wemaxon/IAscher/3d/stl/visor_v1_0_Visor_inner.stl

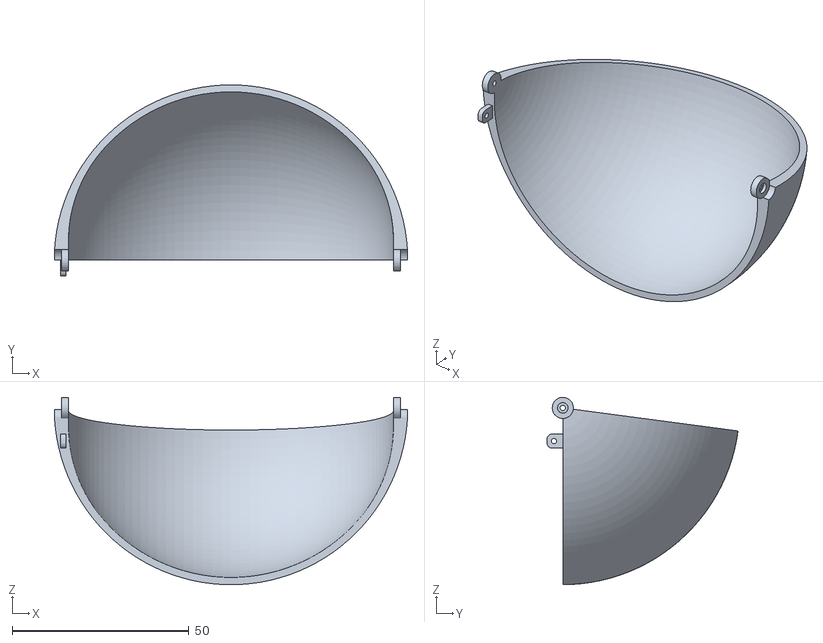
[picture p4: CAD file, 2026-07-22]
3d/stl/visor_v1_0_Visor_inner.stl
99.8 x 54.1 x 53.0
