wemaxon/IAscher/3d/stl/visor_v1_0_cup_insert.stl

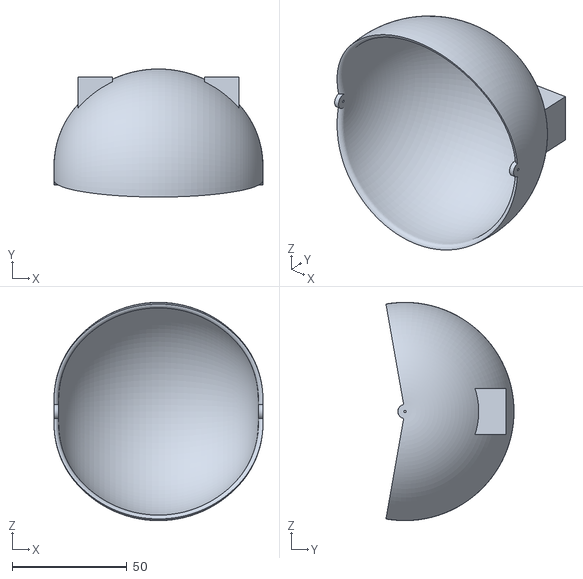
[picture p5: CAD file, 2026-07-22]
3d/stl/visor_v1_0_cup_insert.stl
91.0 x 55.7 x 95.0
