wemaxon/IAscher/3d/stl/visor_v1_0_shell.stl

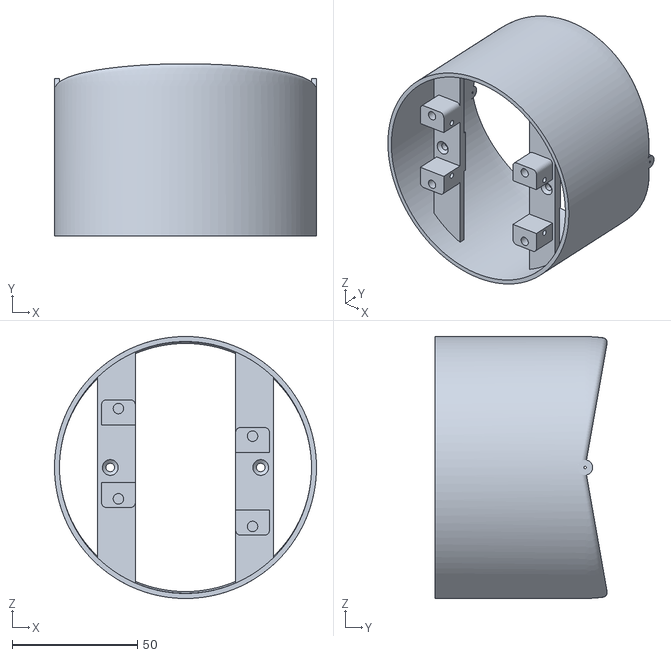
[picture p6: CAD file, 2026-07-22]
3d/stl/visor_v1_0_shell.stl
104.5 x 68.8 x 104.5
