wemaxon/IAscher/3d/stl/visor_v1_0_bottom.stl

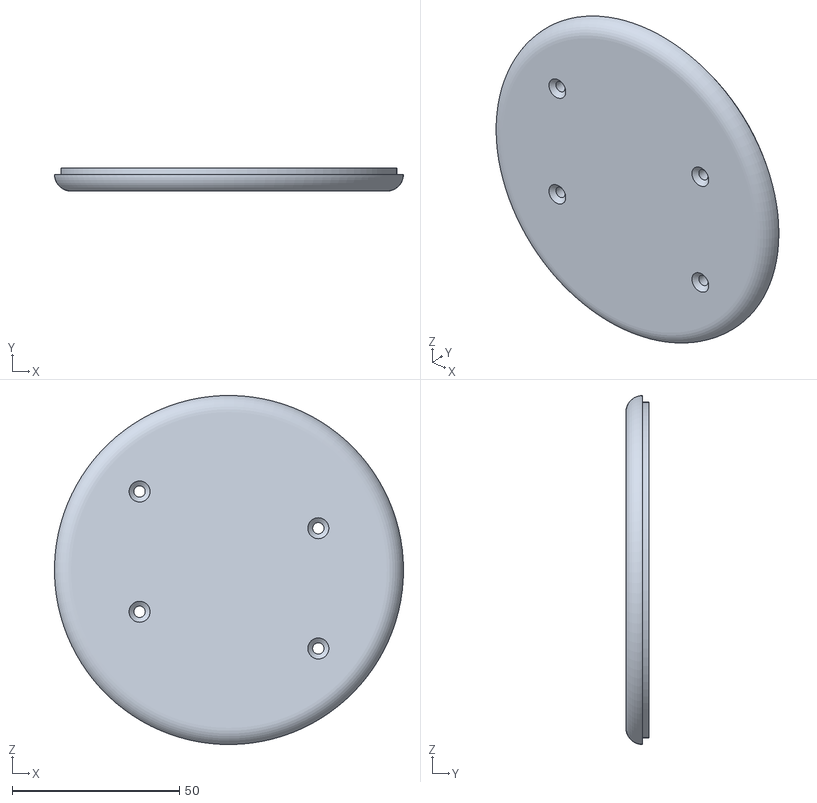
[picture p7: CAD file, 2026-07-22]
3d/stl/visor_v1_0_bottom.stl
104.5 x 7.00 x 104.5
