wemaxon/IAscher/(list of files, cad)

Other CAD files:
3d/stl/visor_v1_0_Visor_outer.stl
