wemaxon/IAscher/(commit log)

2024-01-01 servos working
2024-01-01 add i2c scanner
2024-01-01 add BMI160 Sensor API as submodule
2024-01-01 dumo imu data
2026-07-22 add 3d files
    [IAscher_visor_v1_0_Visor_inner.stl, IAscher_visor_v1_0_Visor_outer.stl, IAscher_visor_v1_0_bottom.stl, IAscher_visor_v1_0_cup_insert.stl, IAscher_visor_v1_0_shell.stl]
2026-07-22 fix and move estimator to attitude_filter, increase rate, fix imu config, add hysteresis
    [attitude_filter.c, attitude_filter.h, imu.c, main.c]
2026-07-27 fix visor open servo position
    [imu.c]
2026-07-27 bmi160 sample 400Hz with INT1
2026-07-27 fix servo angles, show angle status with led
    [imu.c, main.c]
2026-07-27 add cad videos
2026-07-27 update docs, add hardware diagram
    [visor_v1_0_Visor_inner.stl, visor_v1_0_Visor_outer.stl, visor_v1_0_bottom.stl, visor_v1_0_cup_insert.stl, visor_v1_0_shell.stl]
